danielzyy/Smart_Knob/README.md

# Smart_Knob
A multifunctional smart knob capable of simulating haptic feedback using a BLDC motor.
