danielzyy/Smart_Knob/CAD/knob_assembly.SLDASM

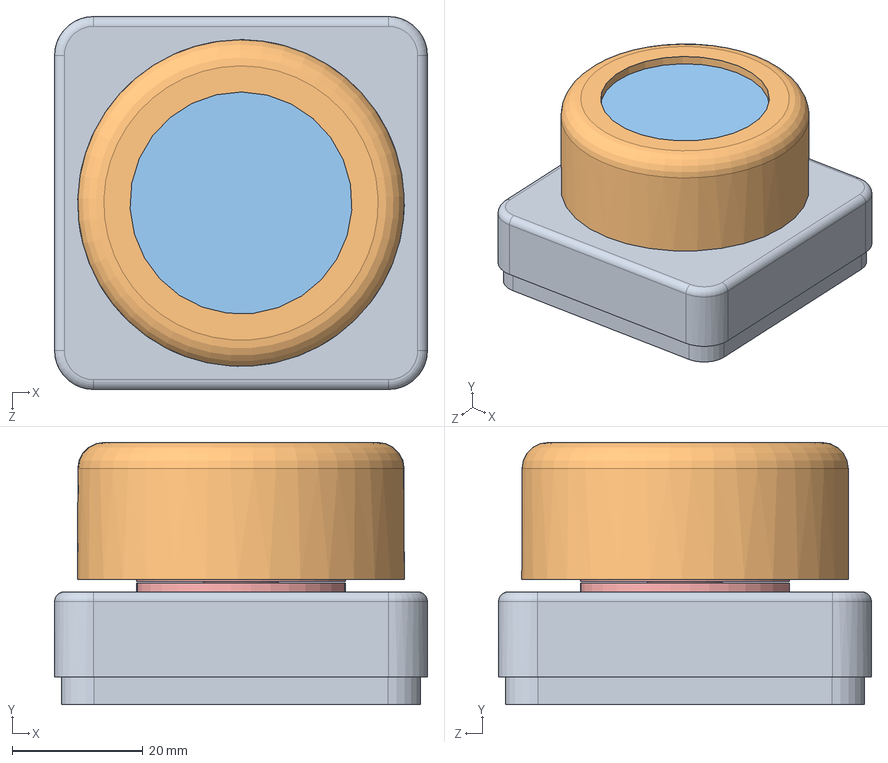
[picture p1: CAD file, 2024-01-05]
CAD/knob_assembly.SLDASM
57.1 x 40.1 x 57.1 mm
base
motor_stand
display_mount
round_display_pcb
motor
motor_cover
GC9A01
display_cover
top_cover
