danielzyy/Smart_Knob/CAD/GC9A01.SLDPRT

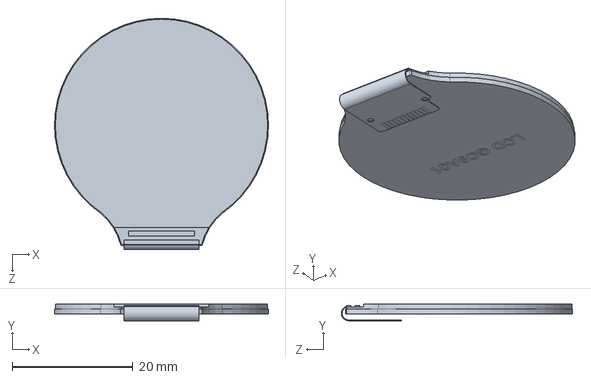
[picture p2: CAD file, 2024-01-05]
CAD/GC9A01.SLDPRT
35.5 x 2.77 x 38.4 mm
