danielzyy/Smart_Knob/CAD/motor.SLDPRT

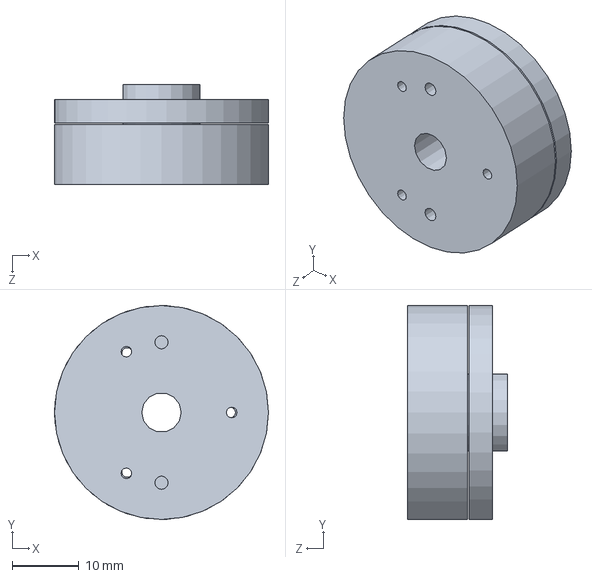
[picture p3: CAD file, 2024-01-05]
CAD/motor.SLDPRT
32.0 x 32.0 x 15.0 mm
