danielzyy/Smart_Knob/CAD/display_mount.SLDPRT

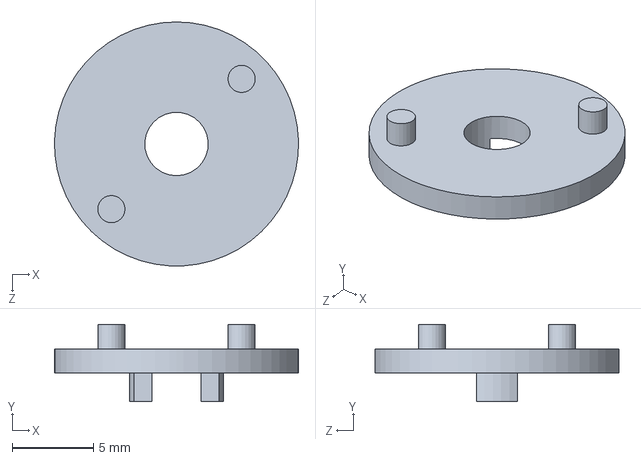
[picture p4: CAD file, 2024-01-05]
CAD/display_mount.SLDPRT
15.0 x 4.75 x 15.0 mm
