danielzyy/Smart_Knob/CAD/motor_stand.SLDPRT

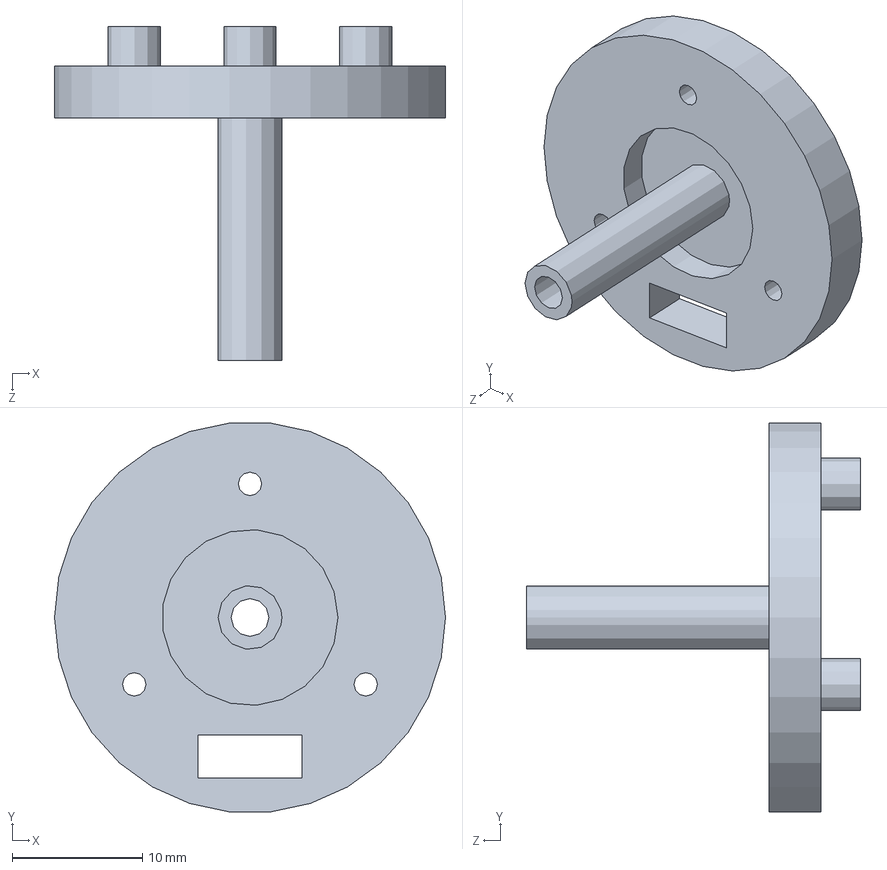
[picture p5: CAD file, 2024-01-05]
CAD/motor_stand.SLDPRT
30.0 x 29.8 x 25.6 mm
