danielzyy/Smart_Knob/CAD/motor_cover.SLDPRT

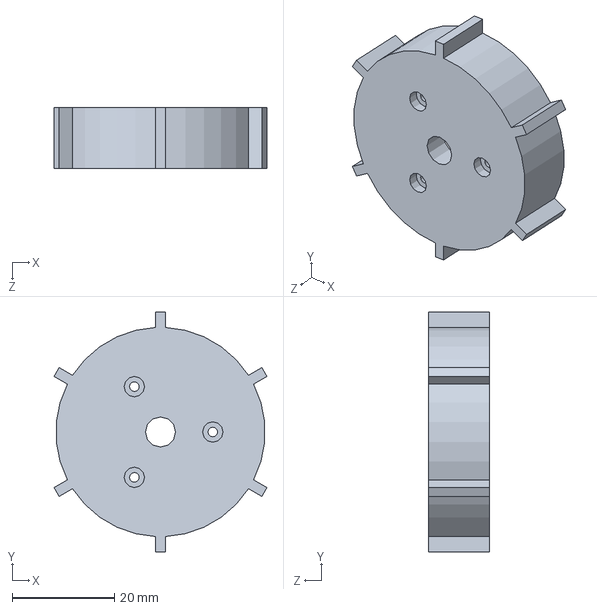
[picture p6: CAD file, 2024-01-05]
CAD/motor_cover.SLDPRT
41.7 x 47.0 x 12.0 mm
