danielzyy/Smart_Knob/CAD/round_display_pcb.SLDPRT

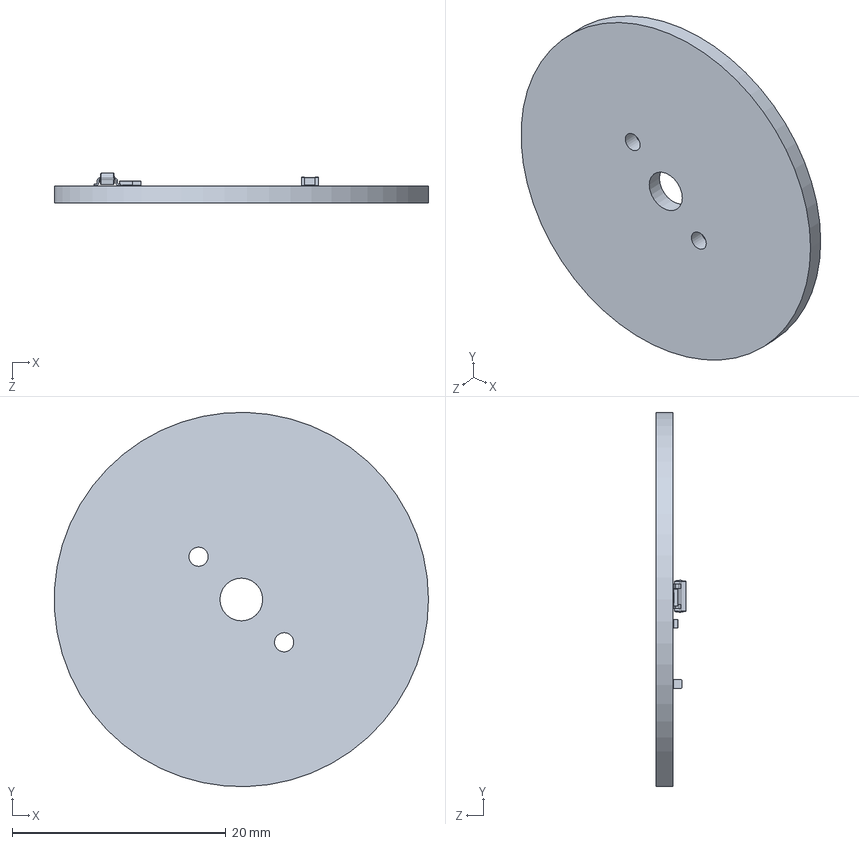
[picture p7: CAD file, 2024-01-05]
CAD/round_display_pcb.SLDPRT
35.0 x 35.0 x 2.83 mm
