danielzyy/Smart_Knob/CAD/display_cover.SLDPRT

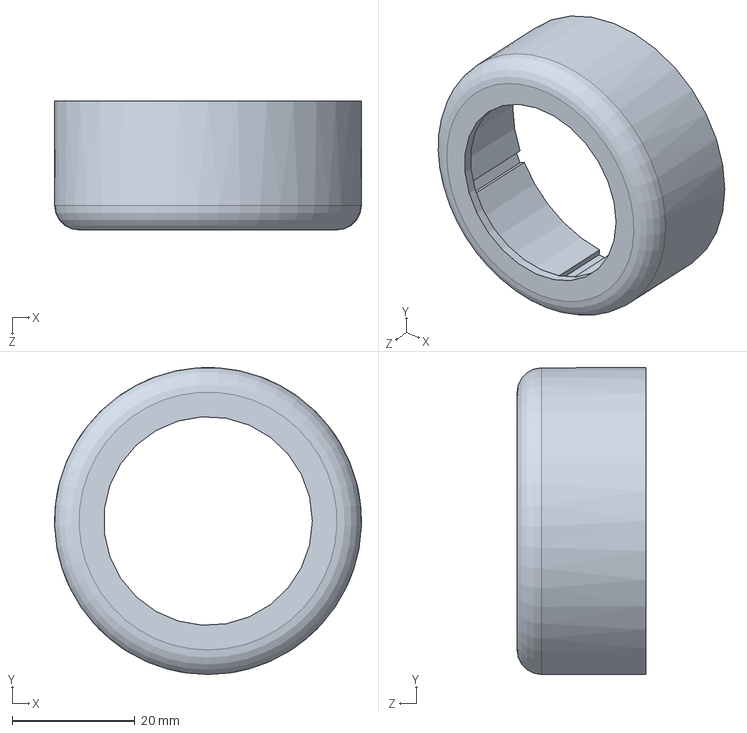
[picture p8: CAD file, 2024-01-05]
CAD/display_cover.SLDPRT
50.0 x 50.0 x 21.0 mm
