danielzyy/Smart_Knob/CAD/top_cover.SLDPRT

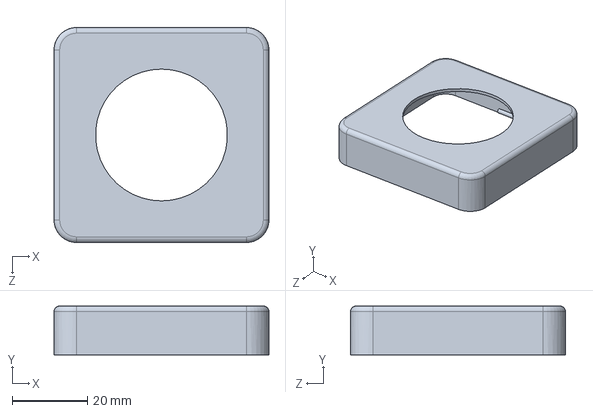
[picture p9: CAD file, 2024-01-05]
CAD/top_cover.SLDPRT
57.1 x 13.0 x 57.1 mm
