danielzyy/Smart_Knob/CAD/base.SLDPRT

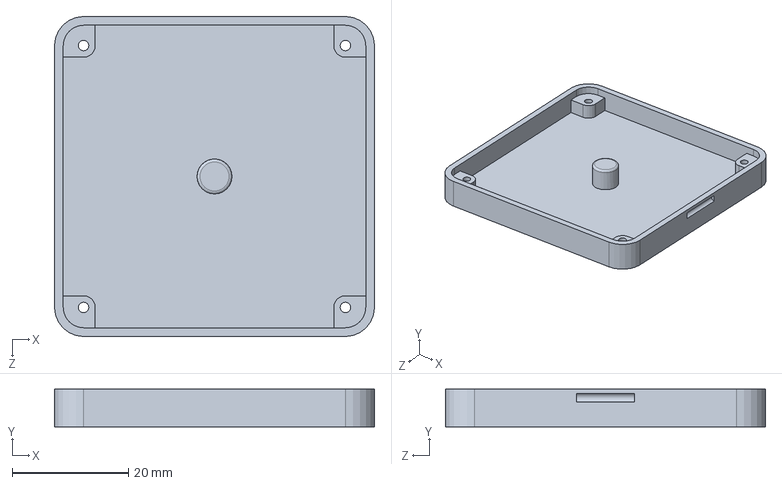
[picture p10: CAD file, 2024-01-05]
CAD/base.SLDPRT
55.0 x 6.50 x 55.0 mm
