danielzyy/Smart_Knob/Electrical/smart_knob_schematic.pdf

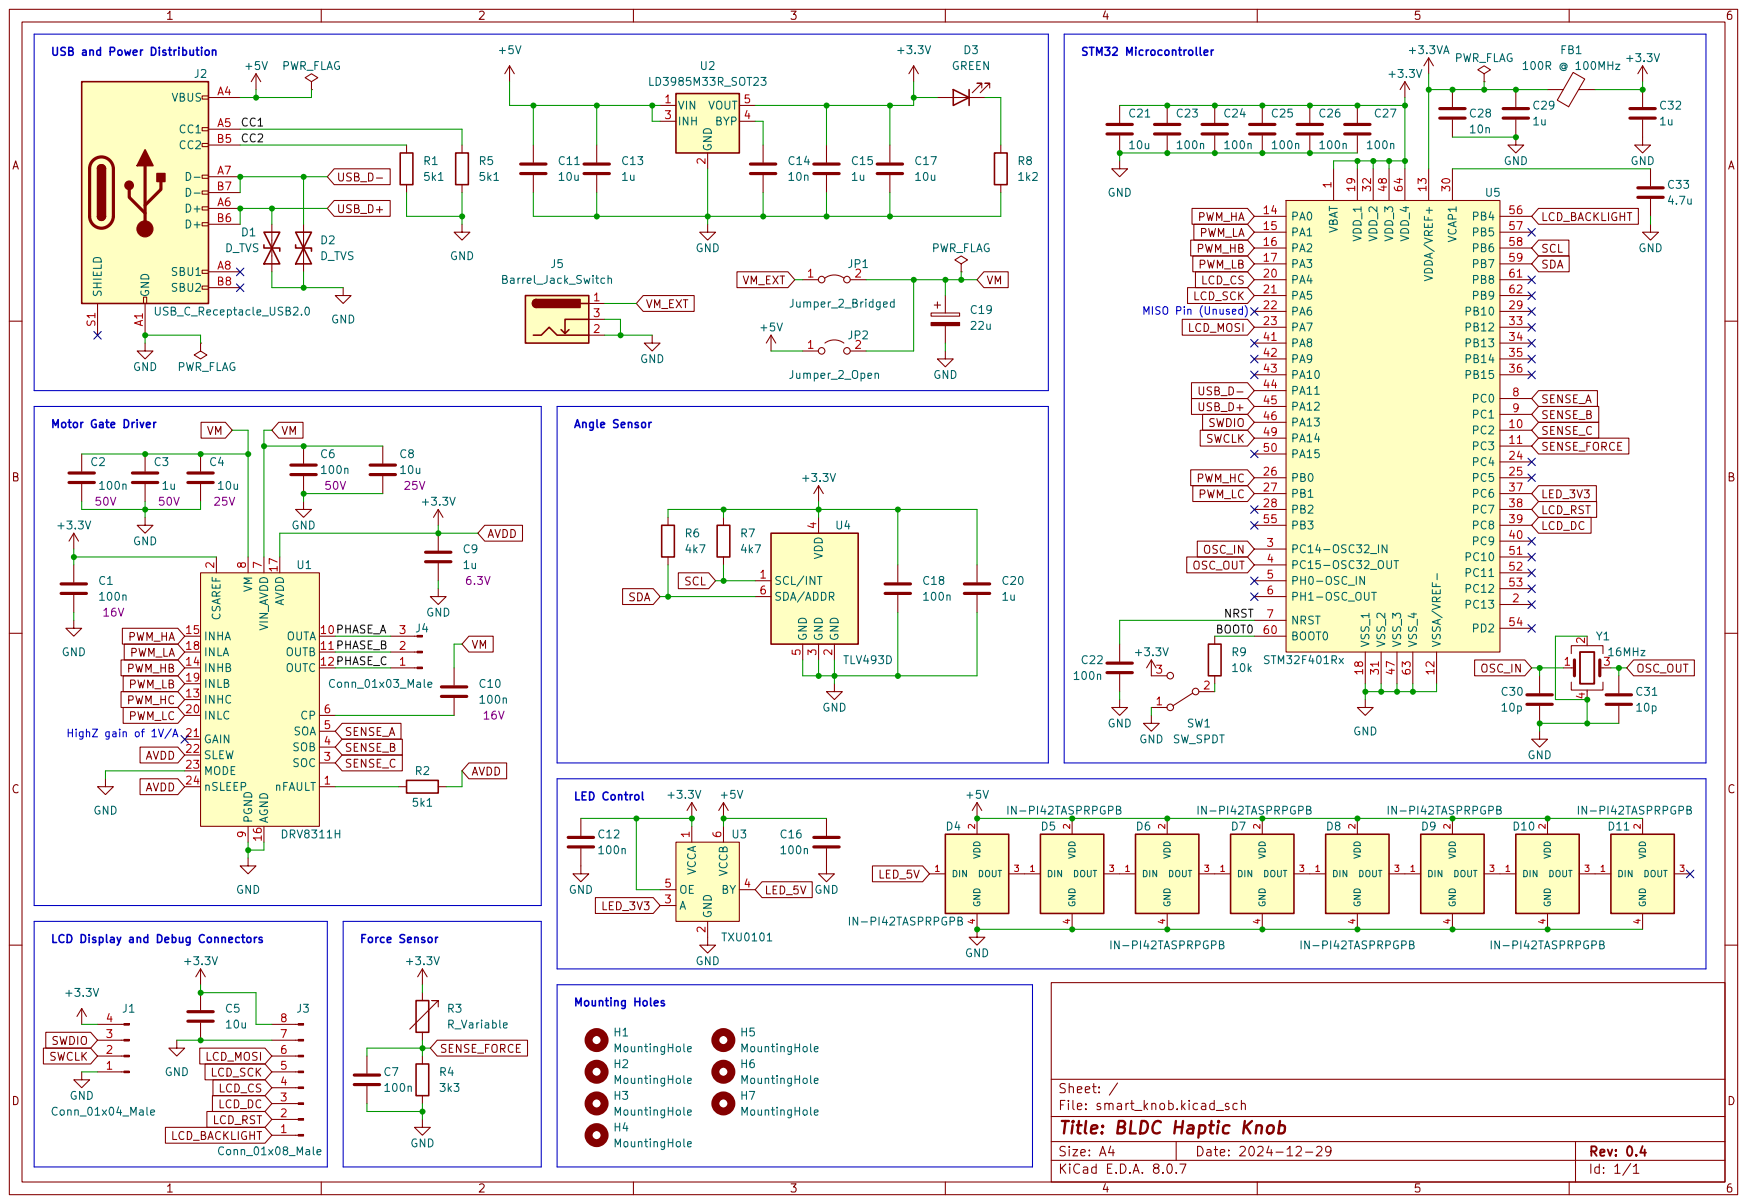
[picture p11: page 1]
