danielzyy/Smart_Knob/Electrical/smart_knob.kicad_pcb

## KiCad design Electrical/smart_knob.kicad_pcb (2025-01-01)

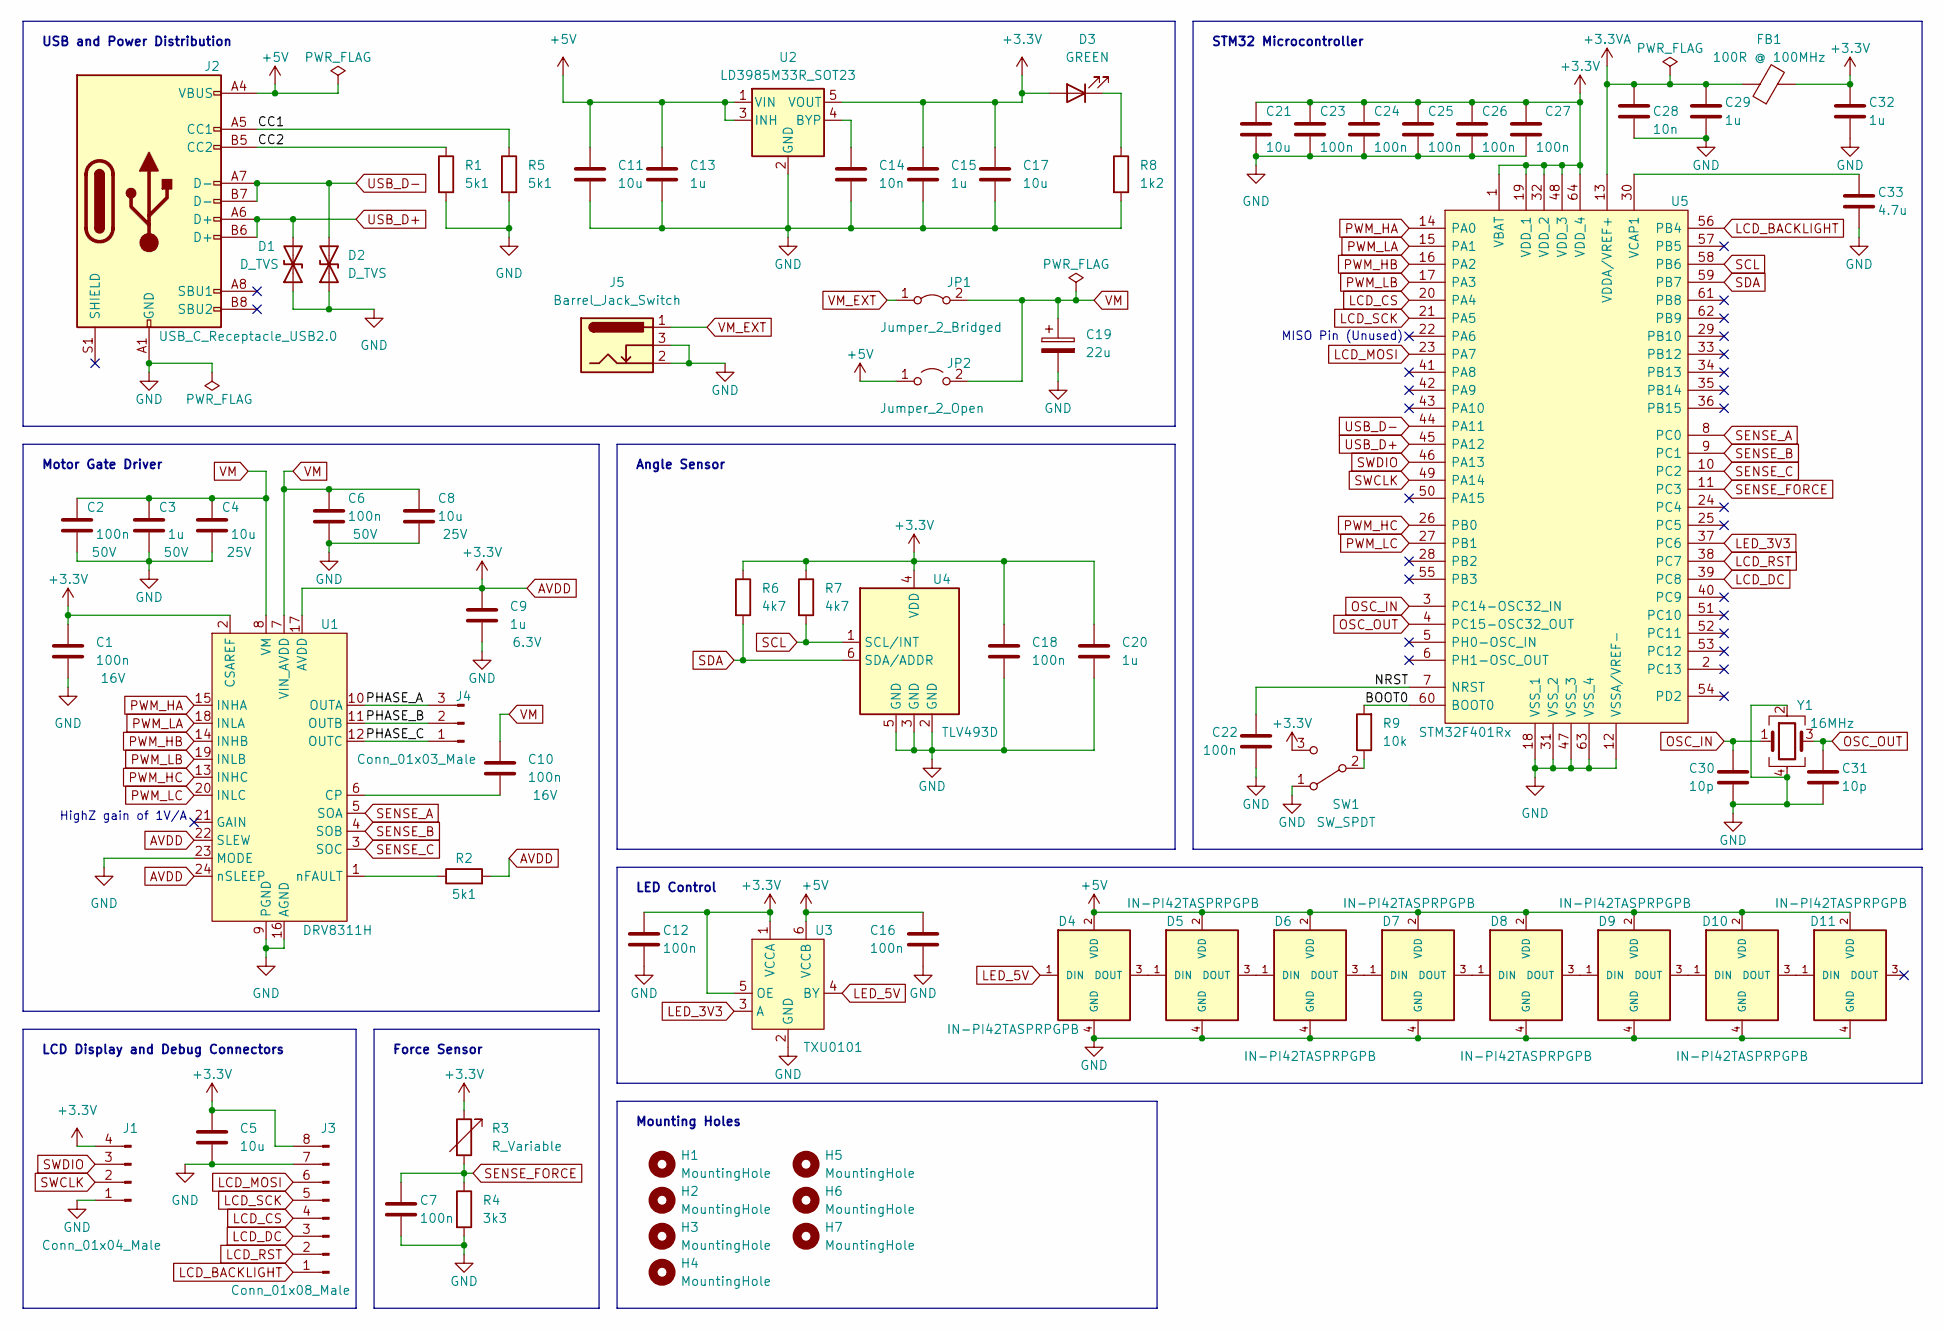
[picture p12: schematic smart_knob.kicad_sch, BLDC Haptic Knob]

Parts:
C1, C10: 100n; C_0603_1608Metric; Rating 16V
C2, C6: 100n; C_0603_1608Metric; Rating 50V
C3: 1u; C_0603_1608Metric; Rating 50V
C4, C8: 10u; C_0603_1608Metric; Rating 25V
C5, C11, C17, C21: 10u; C_0603_1608Metric
C7, C12, C16, C18, C22, C23, C24, C25, C26, C27: 100n; C_0603_1608Metric
C9: 1u; C_0603_1608Metric; Rating 6.3V
C13, C15, C20, C29, C32: 1u; C_0603_1608Metric
C14, C28: 10n; C_0603_1608Metric
C19: 22u; CP_EIA-2012-12_Kemet-R
C30, C31: 10p; C_0603_1608Metric
C33: 4.7u; C_0603_1608Metric
D1, D2: D_TVS; D_0603_1608Metric
D3: GREEN; LED_0603_1608Metric
D4, D5, D6, D7, D8, D9, D10, D11: IN-PI42TASPRPGPB; LED_IN-PI42TASPRPGPB; PARTREV Oct. 10, 2021
FB1: 100R @ 100MHz; L_0603_1608Metric
H1, H2, H3, H4, H5, H6, H7: MountingHole; MountingHole_1.8mm_M1.6
J1: Conn_01x04_Male; PinHeader_1x04_P2.54mm_Horizontal
J2: USB_C_Receptacle_USB2.0; GCT_USB4110-GF-A_REVB_USB2.0
J3: Conn_01x08_Male; LCD_Display
J4: Conn_01x03_Male; Molex_PicoBlade_53261-0371_1x03-1MP_P1.25mm_Horizontal
J5: Barrel_Jack_Switch; TENSILITY_54-00127
JP1: Jumper_2_Bridged; R_0603_1608Metric
JP2: Jumper_2_Open; R_0603_1608Metric
R1, R2, R5: 5k1; R_0603_1608Metric
R3: R_Variable; Force_Sensor
R4: 3k3; R_0603_1608Metric
R6, R7: 4k7; R_0603_1608Metric
R8: 1k2; R_0603_1608Metric
R9: 10k; R_0603_1608Metric
SW1: SW_SPDT; SW_SPDT_CK-JS102011SAQN
U1: DRV8311H; WQFN-24-3x3mm
U2: LD3985M33R_SOT23; SOT-23-5
U3: TXU0101; TXU0101DCKR
U4: TLV493D; SOT-23-6
U5: STM32F401Rx; QFP50P1200X1200X160-64N; Manufacturer_Part_Number STM32F401RET6; Mouser Part Number 511-STM32F401RET6
Y1: 16MHz; Crystal_SMD_Abracon_ABM8G-4Pin_3.2x2.5mm

Connections:
+3.3VA: C28.1, C29.1, FB1.1, U5.13 (VDDA/VREF+)
+5V: C11.1, C13.1, C16.2, D4.2 (VDD), D5.2 (VDD), D6.2 (VDD), D7.2 (VDD), D8.2 (VDD), D9.2 (VDD), D10.2 (VDD), D11.2 (VDD), J2.A4 (VBUS), JP2.1 (A), U2.1 (VIN), U2.3 (INH), U3.6 (VCCB)
/BOOT0: R9.2, U5.60 (BOOT0)
/CC1: J2.A5 (CC1), R5.1
/CC2: J2.B5 (CC2), R1.1
/NRST: C22.1, U5.7 (NRST)
/PHASE_A: J4.3, U1.10 (OUTA)
/PHASE_B: J4.2, U1.11 (OUTB)
/PHASE_C: J4.1, U1.12 (OUTC)
AVDD: C1.1, C5.1, C9.1, C12.2, C15.1, C17.1, C18.1, C20.1, C21.1, C23.1, C24.1, C25.1, C26.1, C27.1, C32.1, D3.2 (A), FB1.2, J1.4, J3.8, R2.2, R3.1, R6.1, R7.1, SW1.3 (C), U1.2 (CSAREF), U1.17 (AVDD), U1.22 (SLEW), U1.24 (nSLEEP), U2.5 (VOUT), U3.1 (VCCA), U3.5 (OE), U4.4 (VDD), U5.1 (VBAT), U5.19 (VDD_1), U5.32 (VDD_2), U5.48 (VDD_3), U5.64 (VDD_4)
GND: C1.2, C2.1, C3.2, C4.2, C5.2, C6.1, C7.2, C8.2, C9.2, C11.2, C12.1, C13.2, C14.2, C15.2, C16.1, C17.2, C18.2, C19.2, C20.2, C21.2, C22.2, C23.2, C24.2, C25.2, C26.2, C27.2, C28.2, C29.2, C30.2, C31.2, C32.2, C33.2, D1.1 (A1), D2.1 (A1), D4.4 (GND), D5.4 (GND), D6.4 (GND), D7.4 (GND), D8.4 (GND), D9.4 (GND), D10.4 (GND), D11.4 (GND), J1.1, J2.A1 (GND), J3.7, J5.2, J5.3, R1.2, R4.2, R5.2, R8.2, SW1.1 (A), U1.9 (PGND), U1.16 (AGND), U1.23 (MODE), U2.2 (GND), U3.2 (GND), U4.2 (GND), U4.3 (GND), U4.5 (GND), U5.12 (VSSA/VREF-), U5.18 (VSS_1), U5.31 (VSS_2), U5.47 (VSS_3), U5.63 (VSS_4), Y1.2, Y1.4
LCD_BACKLIGHT: J3.1, U5.56 (PB4)
LCD_CS: J3.4, U5.20 (PA4)
LCD_DC: J3.3, U5.39 (PC8)
LCD_MOSI: J3.6, U5.23 (PA7)
LCD_RST: J3.2, U5.38 (PC7)
LCD_SCK: J3.5, U5.21 (PA5)
LED_3V3: U3.3 (A), U5.37 (PC6)
LED_5V: D4.1 (DIN), U3.4 (BY)
unnamed: D3.1 (K), R8.1
unnamed: D4.3 (DOUT), D5.1 (DIN)
unnamed: D5.3 (DOUT), D6.1 (DIN)
unnamed: D6.3 (DOUT), D7.1 (DIN)
unnamed: D7.3 (DOUT), D8.1 (DIN)
unnamed: D8.3 (DOUT), D9.1 (DIN)
unnamed: D9.3 (DOUT), D10.1 (DIN)
unnamed: D10.3 (DOUT), D11.1 (DIN)
unnamed: R9.1, SW1.2 (B)
unnamed: C10.1, U1.6 (CP)
unnamed: R2.1, U1.1 (nFAULT)
unnamed: C14.1, U2.4 (BYP)
unnamed: C33.1, U5.30 (VCAP1)
OSC_IN: C30.1, U5.3 (PC14-OSC32_IN), Y1.1
OSC_OUT: C31.1, U5.4 (PC15-OSC32_OUT), Y1.3
PWM_HA: U1.15 (INHA), U5.14 (PA0)
PWM_HB: U1.14 (INHB), U5.16 (PA2)
PWM_HC: U1.13 (INHC), U5.26 (PB0)
PWM_LA: U1.18 (INLA), U5.15 (PA1)
PWM_LB: U1.19 (INLB), U5.17 (PA3)
PWM_LC: U1.20 (INLC), U5.27 (PB1)
SCL: R7.2, U4.1 (SCL/INT), U5.58 (PB6)
SDA: R6.2, U4.6 (SDA/ADDR), U5.59 (PB7)
SENSE_A: U1.5 (SOA), U5.8 (PC0)
SENSE_B: U1.4 (SOB), U5.9 (PC1)
SENSE_C: U1.3 (SOC), U5.10 (PC2)
SENSE_FORCE: C7.1, R3.2, R4.1, U5.11 (PC3)
SWCLK: J1.2, U5.49 (PA14)
SWDIO: J1.3, U5.46 (PA13)
USB_D+: D1.2 (A2), J2.A6 (D+), J2.B6 (D+), U5.45 (PA12)
USB_D-: D2.2 (A2), J2.A7 (D-), J2.B7 (D-), U5.44 (PA11)
VM: C2.2, C3.1, C4.1, C6.2, C8.1, C10.2, C19.1, JP1.2 (B), JP2.2 (B), U1.7 (VIN_AVDD), U1.8 (VM)
VM_EXT: J5.1, JP1.1 (A)

Notes on the sheet:
MISO Pin (Unused)
Mounting Holes
LCD Display and Debug Connectors
USB and Power Distribution
Force Sensor
LED Control
HighZ gain of 1V/A
STM32 Microcontroller
Angle Sensor
Motor Gate Driver

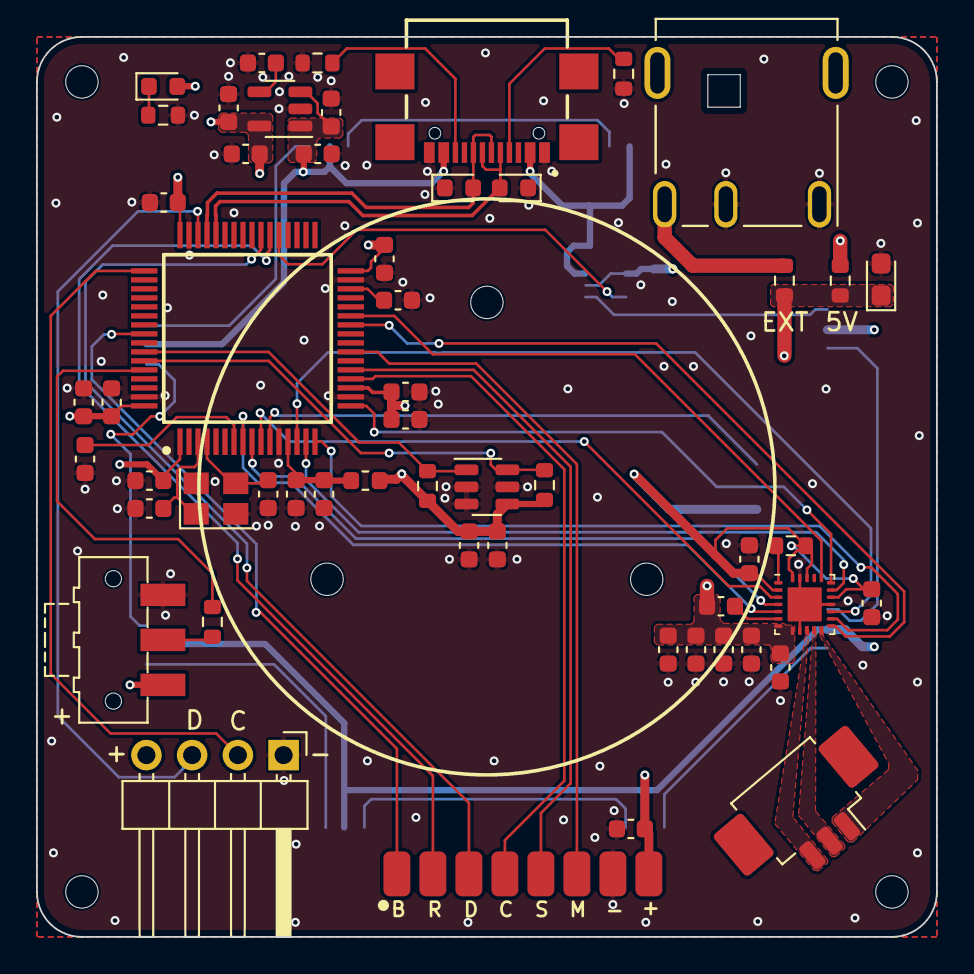
[picture p13: board smart_knob.kicad_pcb from above]

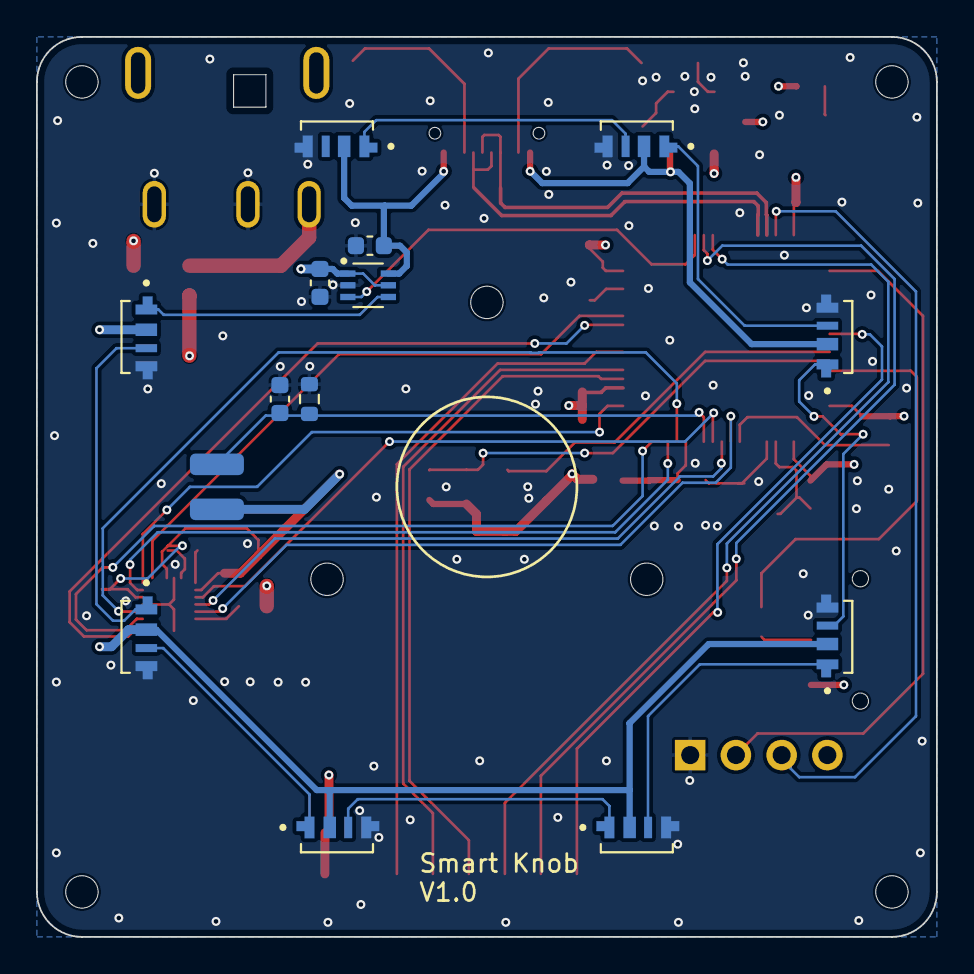
[picture p14: board smart_knob.kicad_pcb from below]

Board: 4 copper layers, 50.0 x 50.0 mm, 75 parts (14 on the bottom side), 52 nets.
