danielzyy/Smart_Knob/(commit log)

2024-01-05 initial upload
    [GC9A01.SLDPRT, base.SLDPRT, display_cover.SLDPRT, display_mount.SLDPRT, knob_assembly.SLDASM, motor.SLDPRT, motor_cover.SLDPRT, motor_stand.SLDPRT]
2025-01-01 fix i2c crash preventing usb input
    [angleSensor.cpp, angleSensor.h, display.cpp, main.cpp, motor.cpp, usb.cpp]
2025-01-01 fix schematic rework issues
    [smart_knob.kicad_pcb, smart_knob.kicad_sch]
2025-01-01 pcb interactive bom for assembly
